craigyjp/Moog-Source-clone/schematics/VCO1.pdf

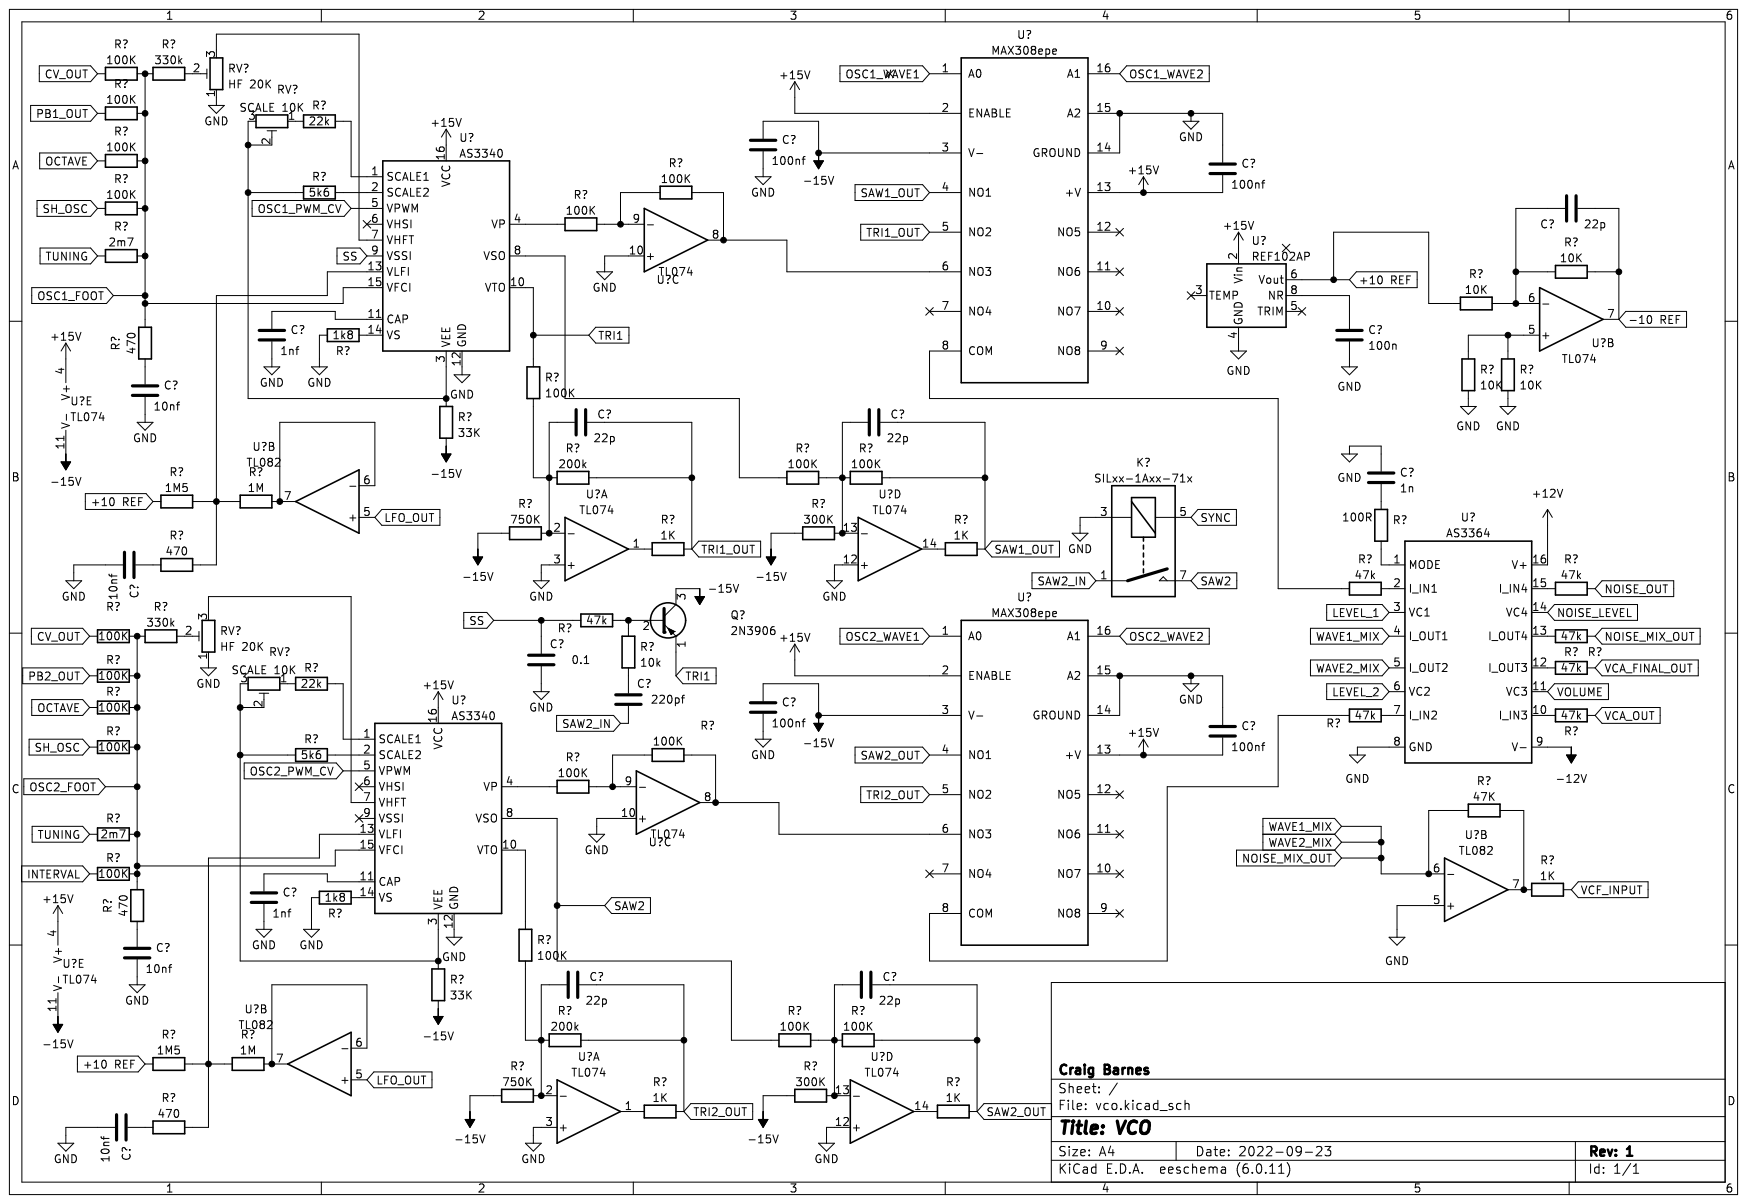
[picture p2: page 1]
