craigyjp/Moog-Source-clone/schematics/DACs2.pdf

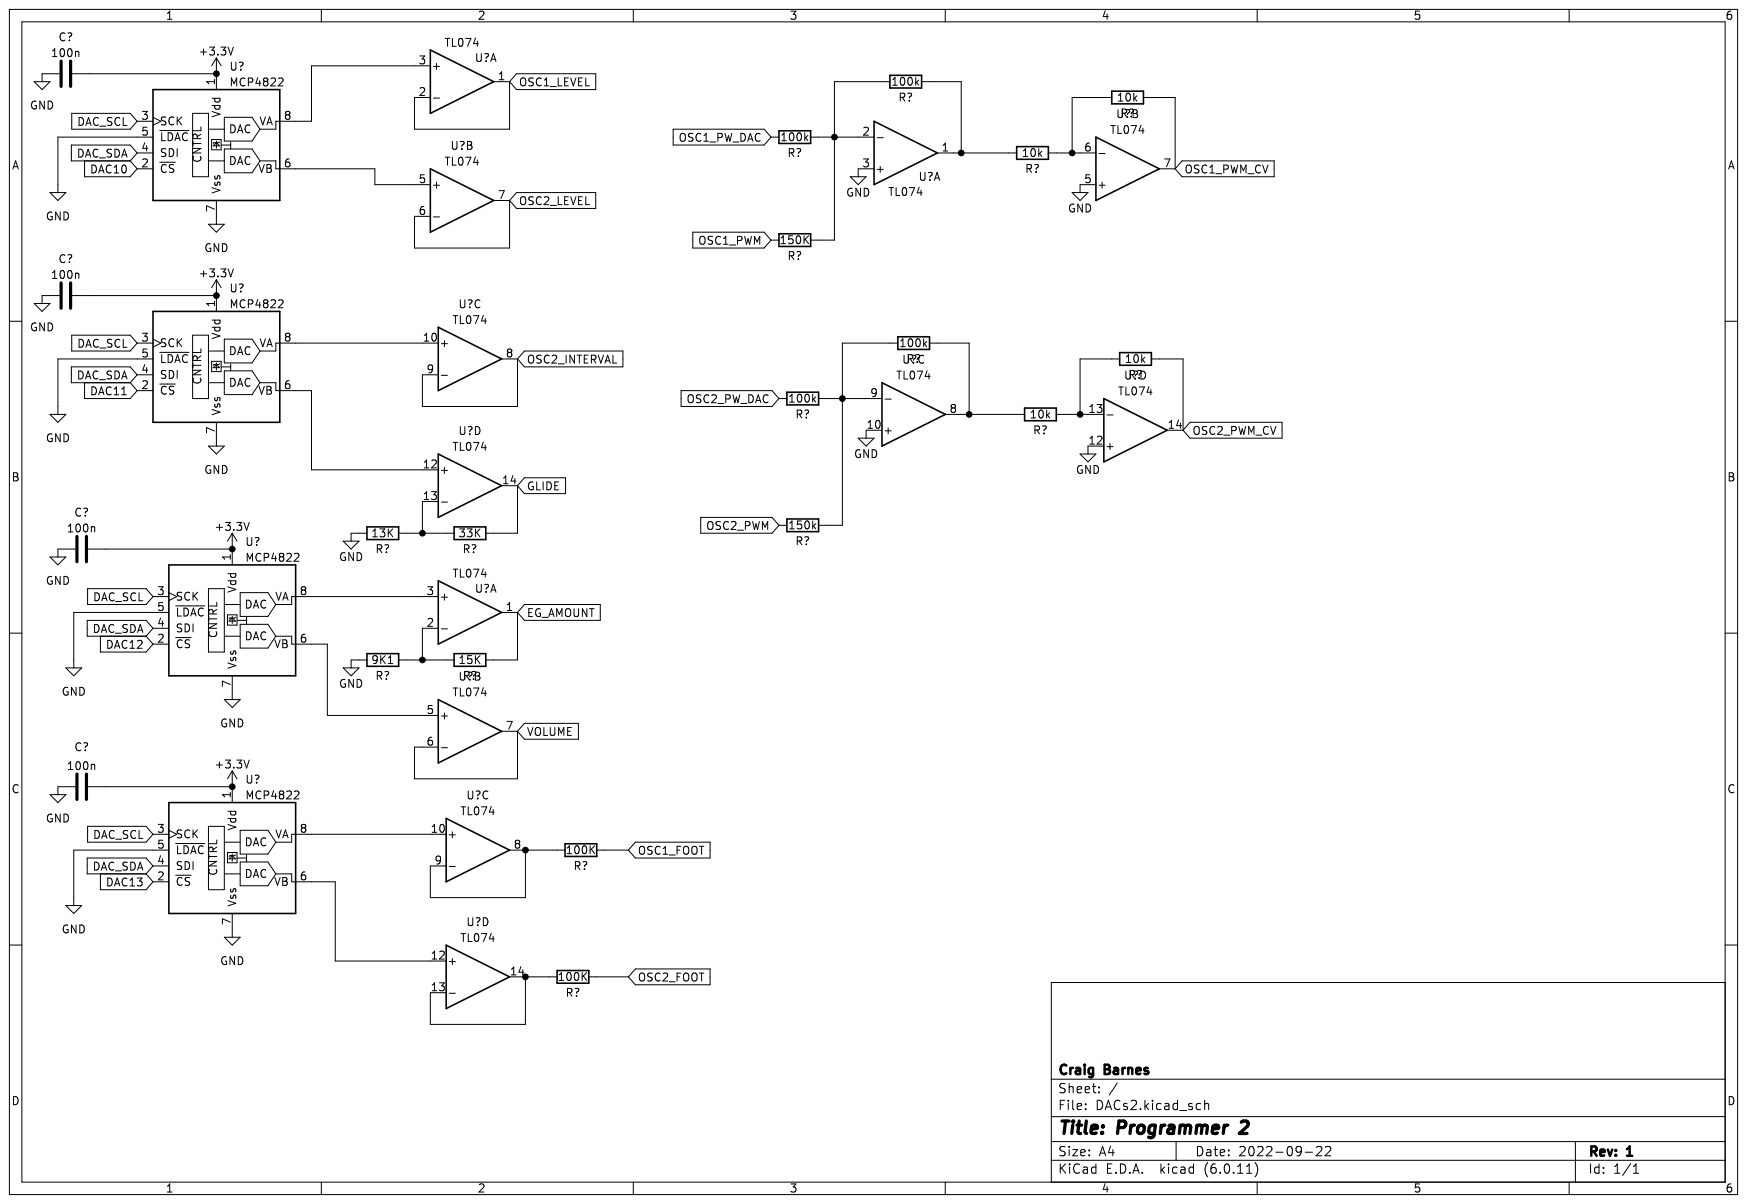
[picture p3: page 1]
