craigyjp/Moog-Source-clone/schematics/filter.pdf

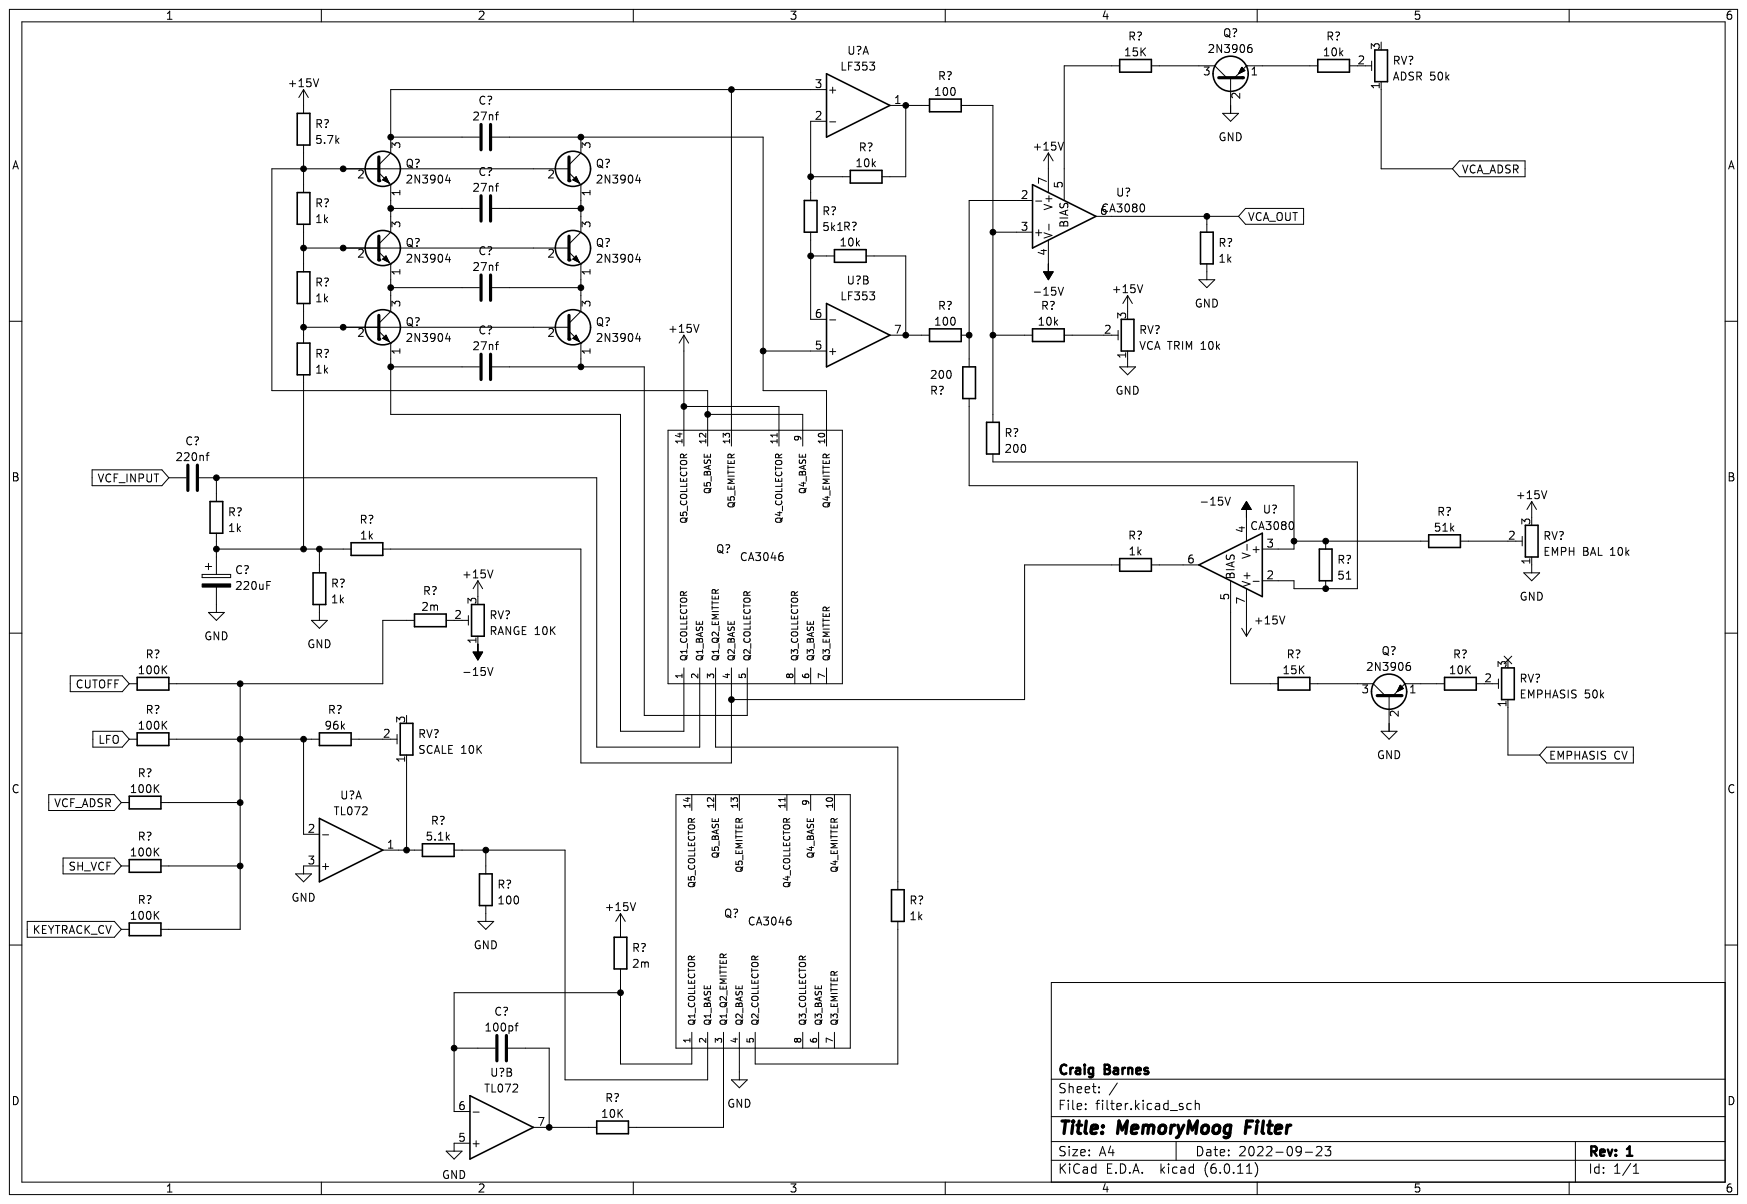
[picture p4: page 1]
