craigyjp/Moog-Source-clone/schematics/Routing_and_EGs.pdf

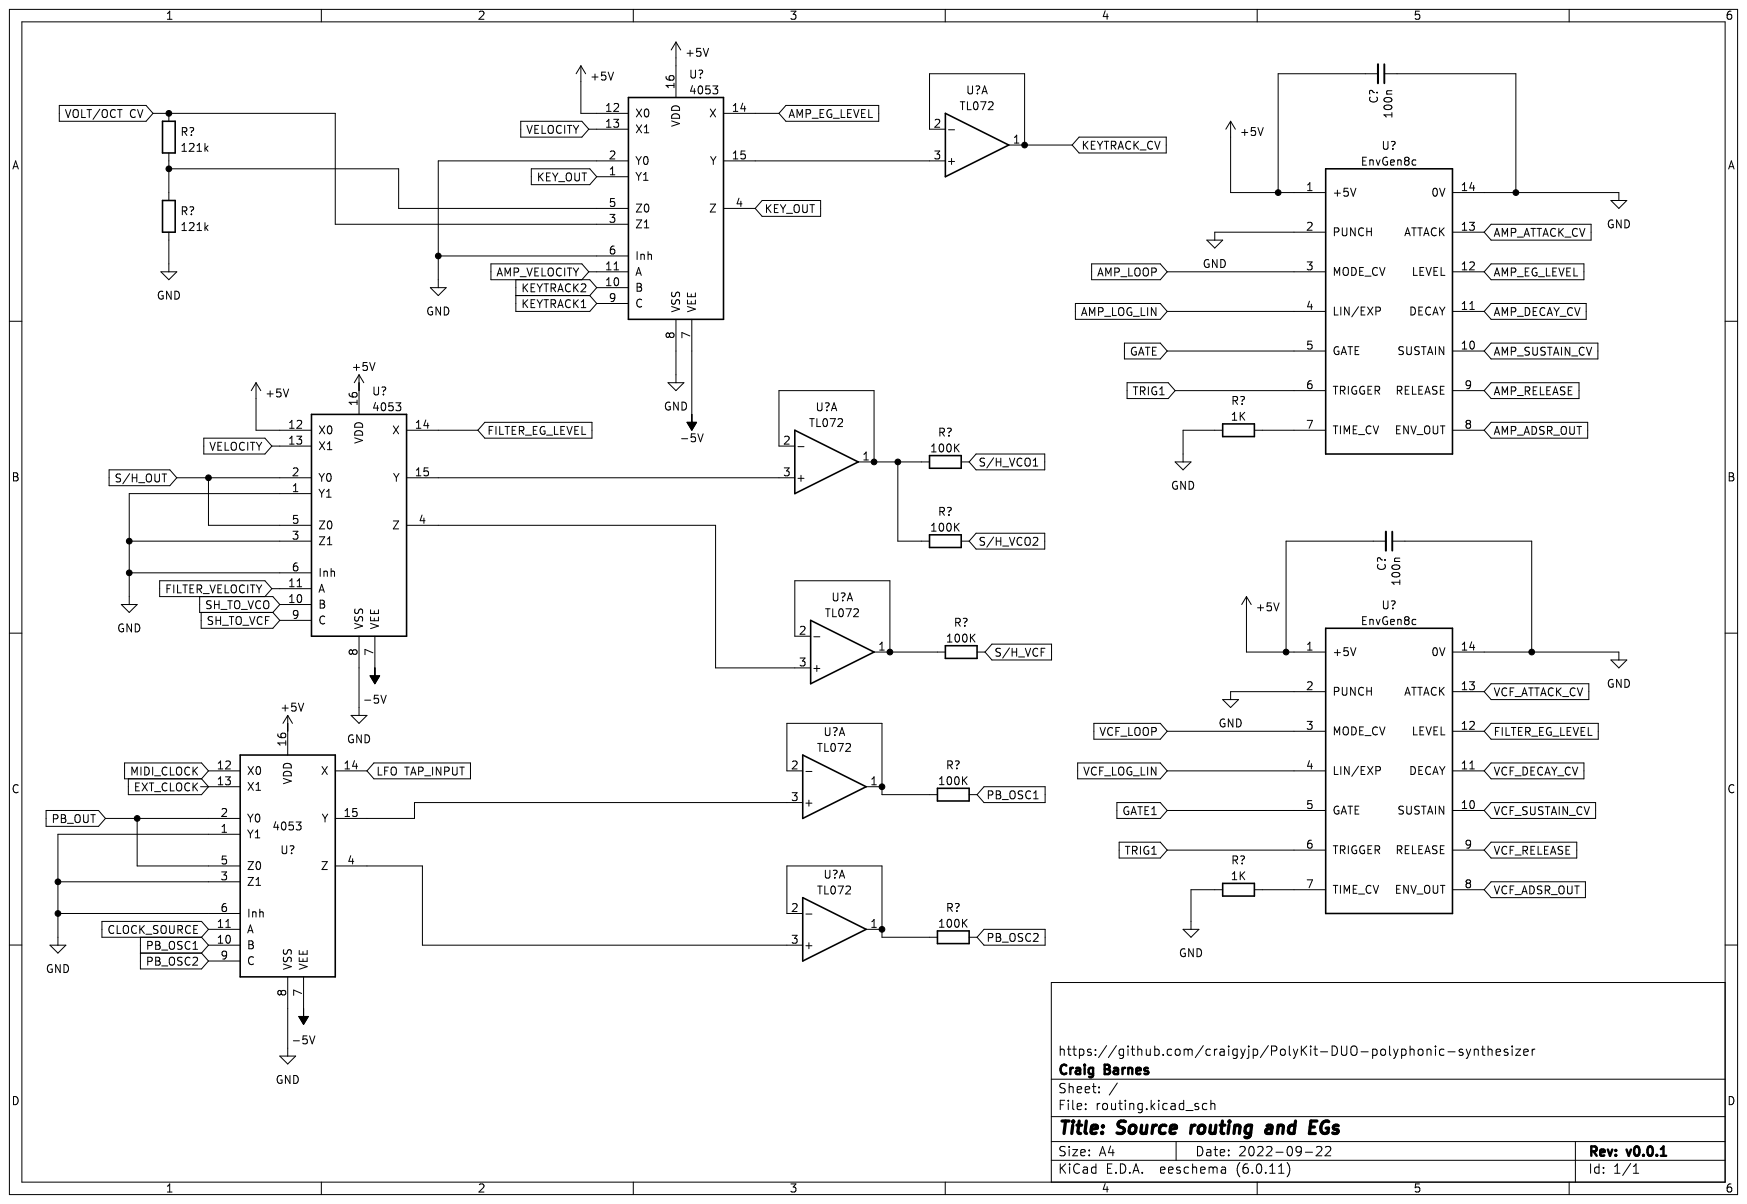
[picture p5: page 1]
