craigyjp/Moog-Source-clone/schematics/Teensy 3.6.pdf

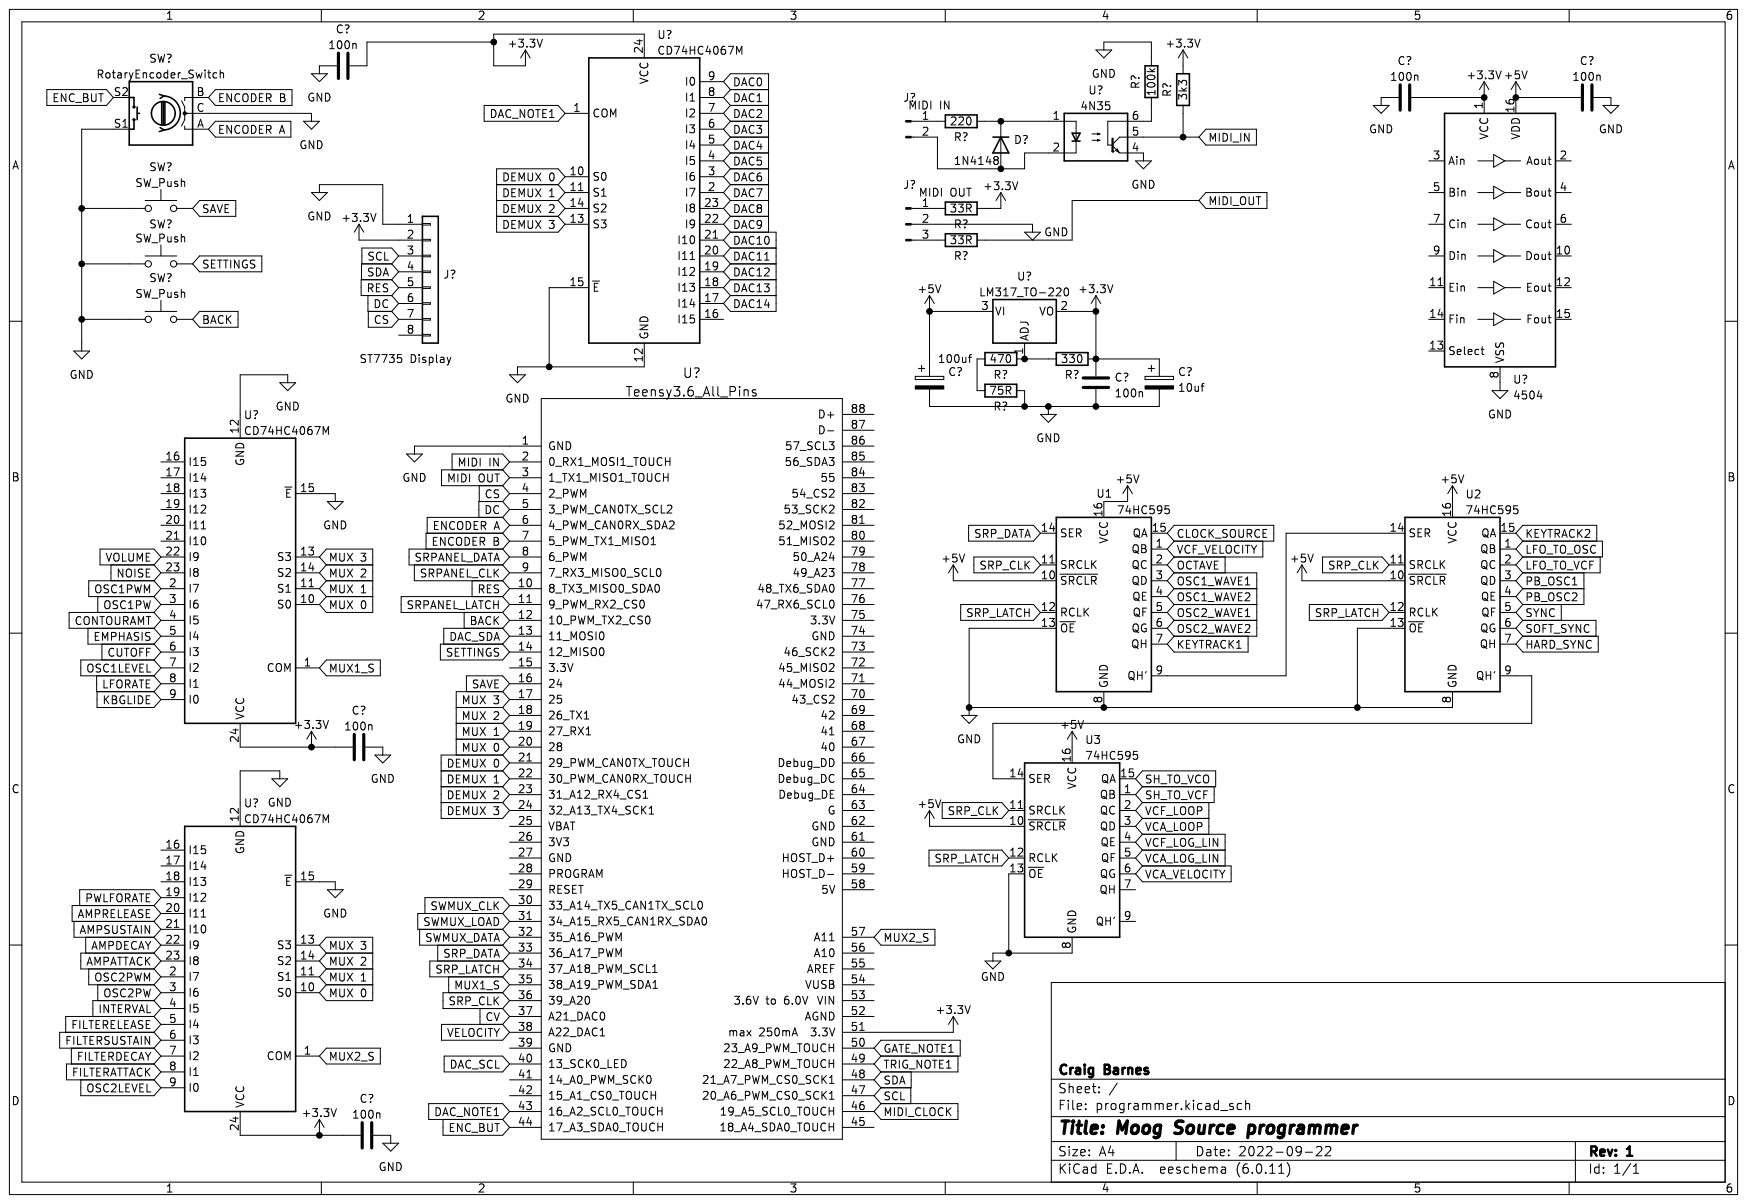
[picture p6: page 1]
