craigyjp/Moog-Source-clone/schematics/Frontpanel_switches_and_leds.pdf

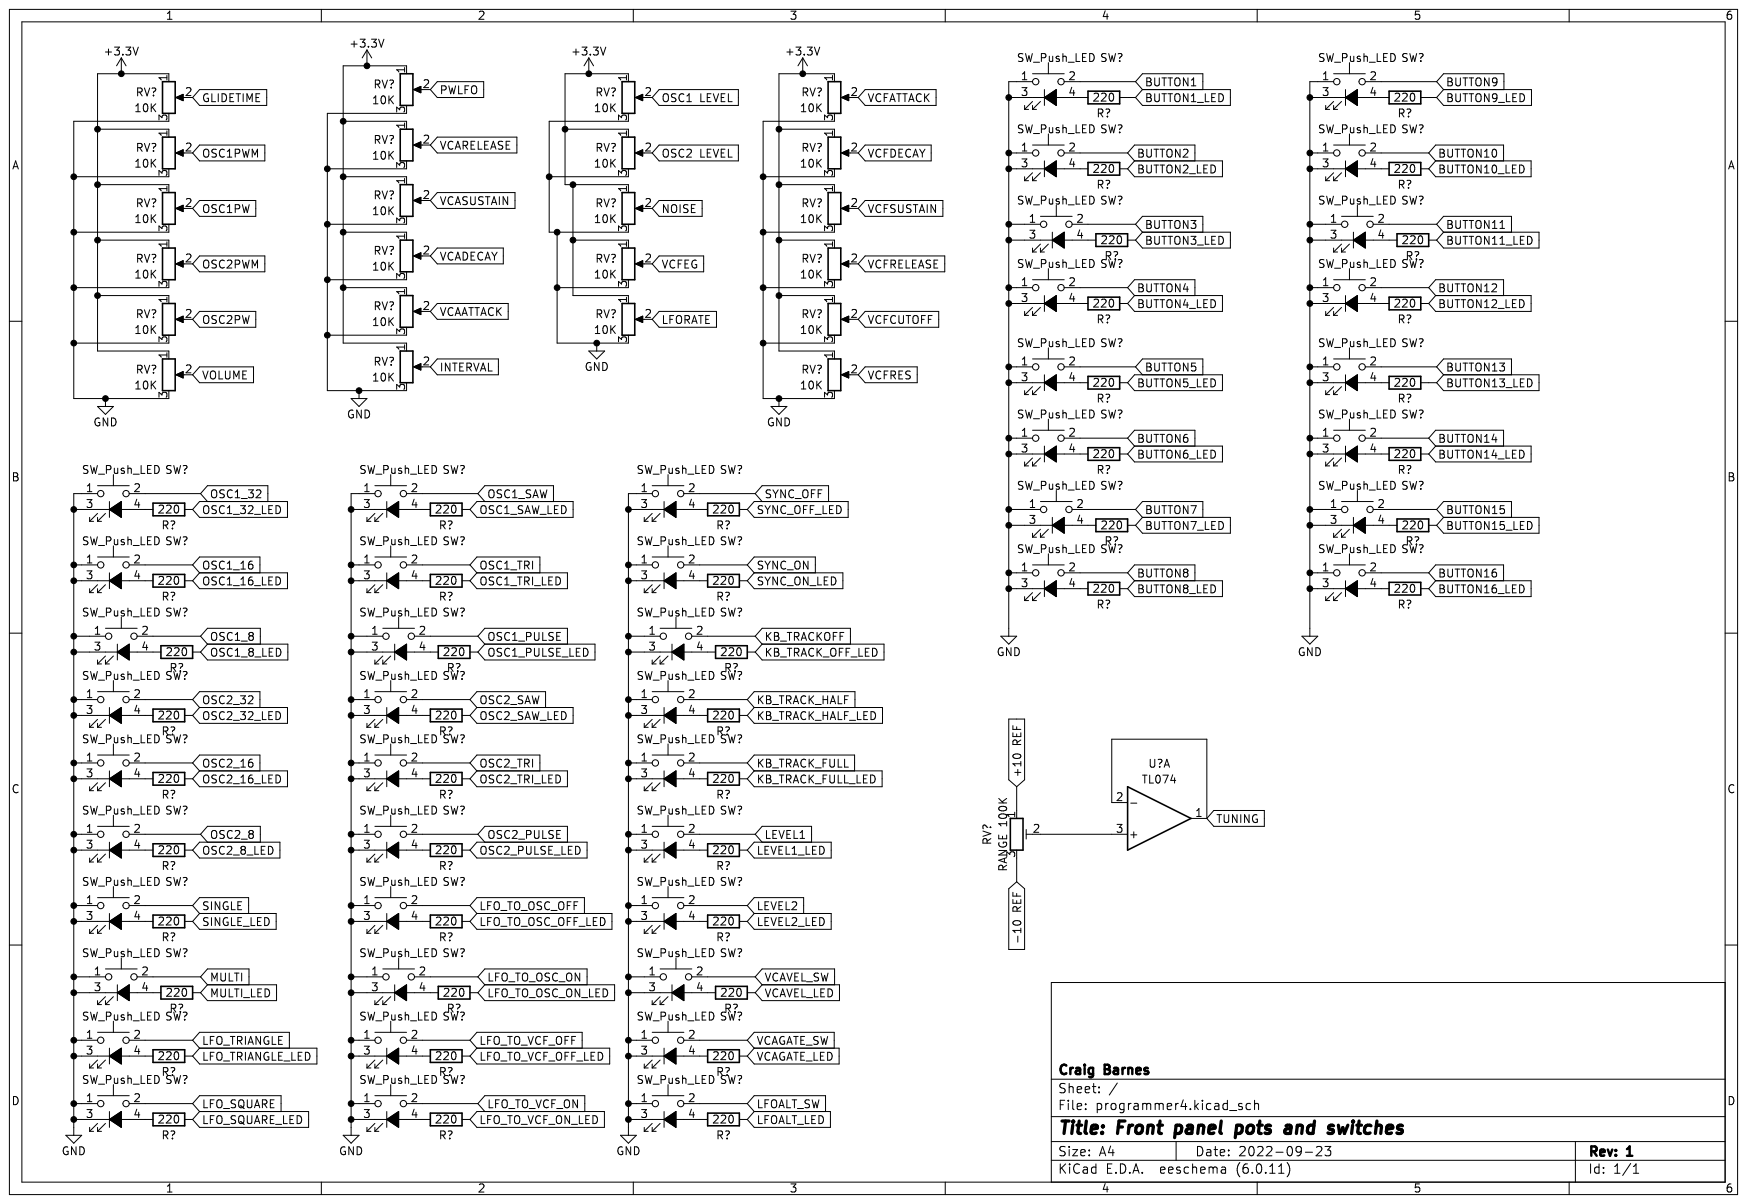
[picture p7: page 1]
