craigyjp/Moog-Source-clone/schematics/LFOs.pdf

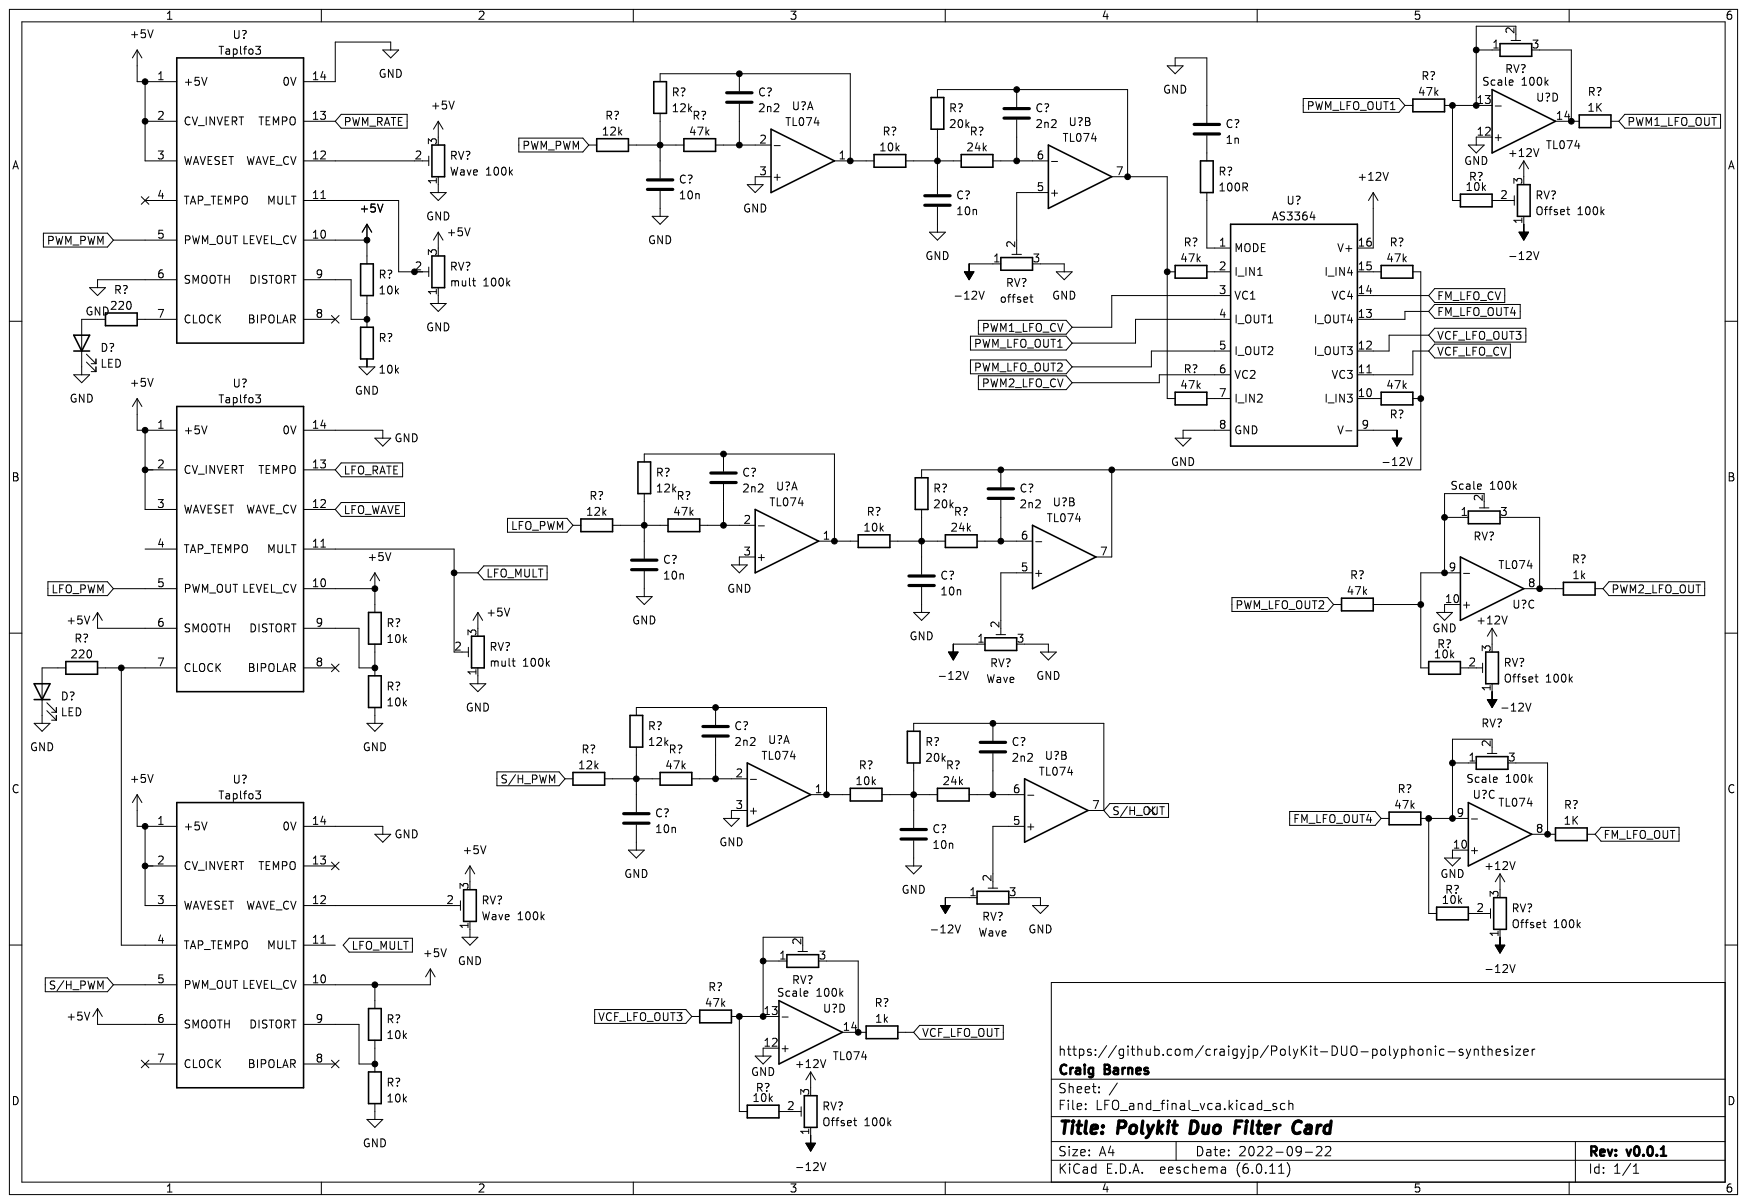
[picture p8: page 1]
