craigyjp/Moog-Source-clone/schematics/VCO2.pdf

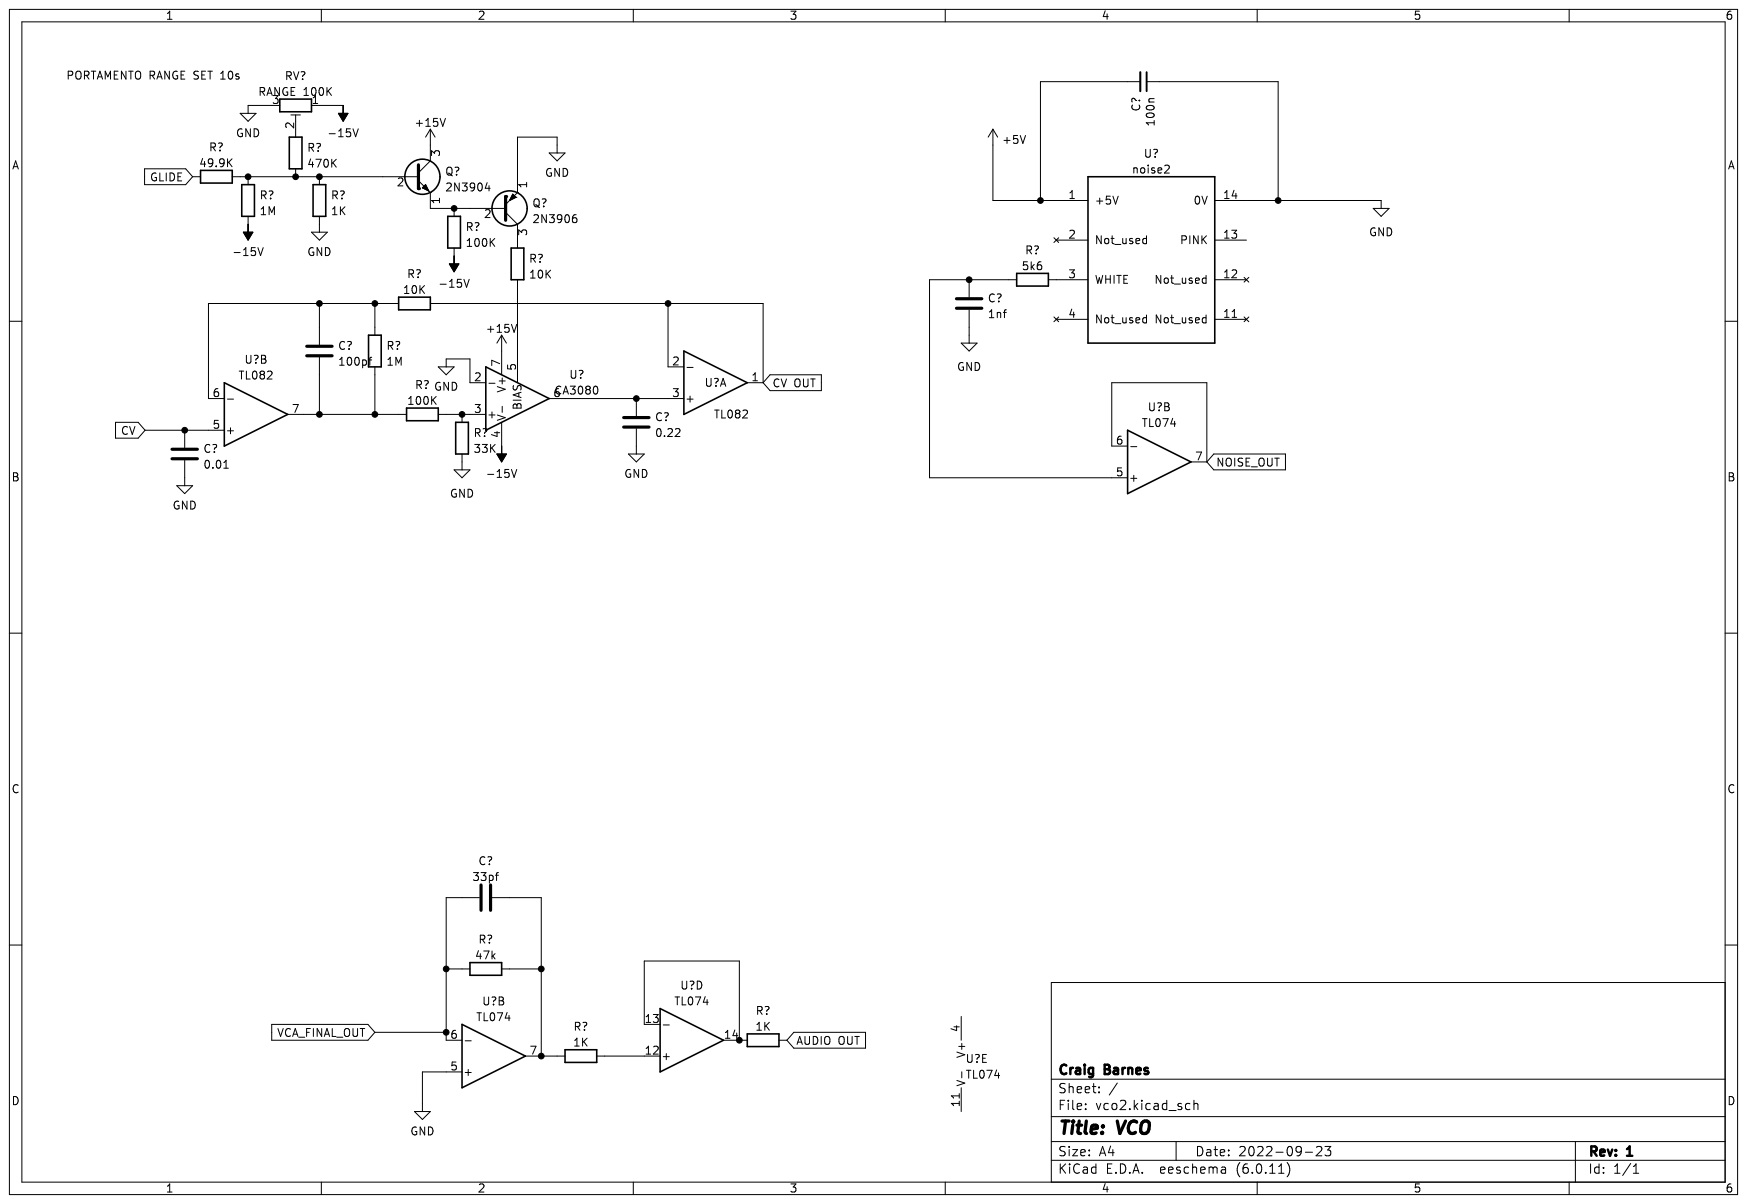
[picture p9: page 1]
