craigyjp/Moog-Source-clone/schematics/DACs1.pdf

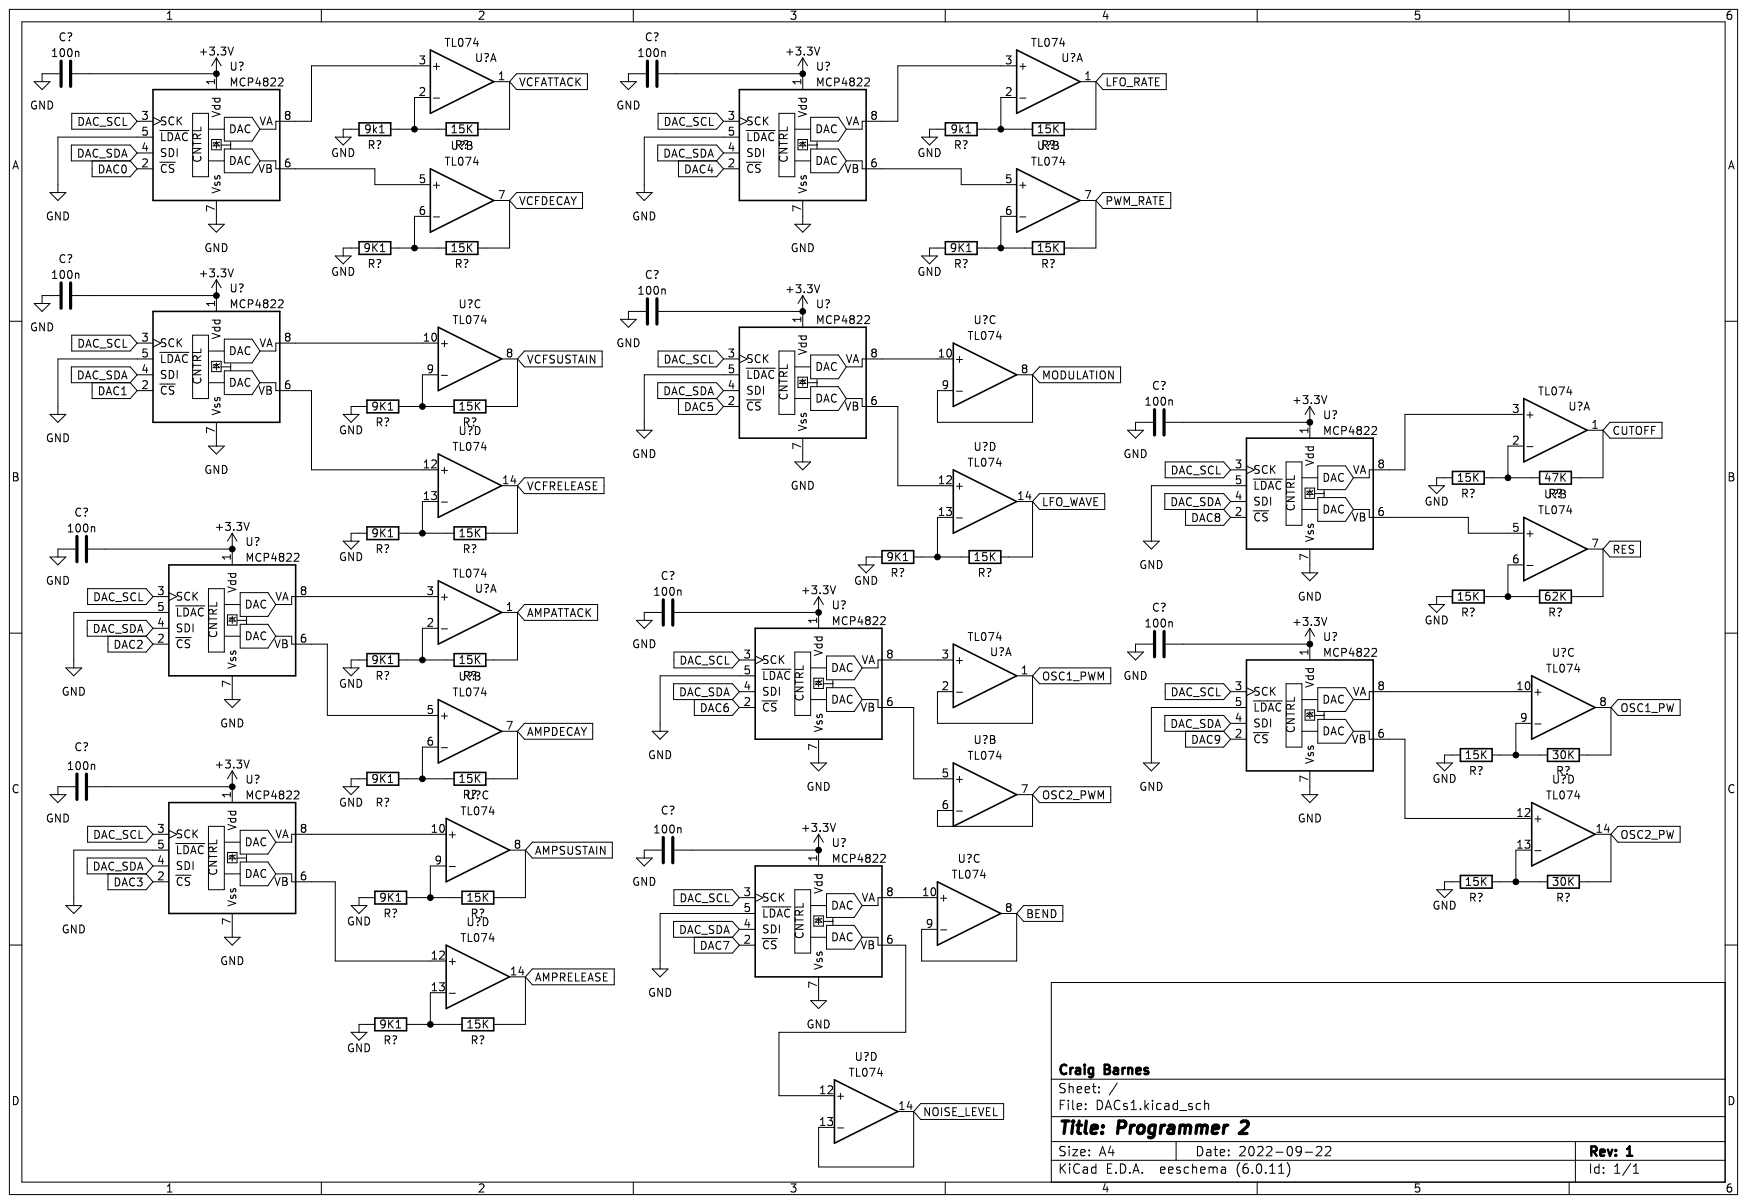
[picture p10: page 1]
