craigyjp/Moog-Source-clone/code/Parameters.h

//Values below are just for initialising and will be changed when synth is initialised to current panel controls & EEPROM settings
byte midiChannel = MIDI_CHANNEL_OMNI;//(EEPROM)
String patchName = INITPATCHNAME;
boolean encCW = true;//This is to set the encoder to increment when turned CW - Settings Option

unsigned int CV =0;
unsigned int velCV = 0;

constexpr int POT_MAX = 1023;
constexpr int DETUNE_END = POT_MAX / 4;

int offset;

int modWheelDepth = 0;
int pitchBendRange = 0;
int afterTouchDepth = 0;
int bended = 1024;
int keyMode = 0;
static unsigned long clock_timer = 0, clock_timeout = 0;
static unsigned int clock_count = 0;
int clocksource = 0;
int oldclocksource = 0;
int oldnote = 0;

constexpr uint8_t MAX_ARP_STEPS = 24;

uint8_t arpNotes[MAX_ARP_STEPS];
uint8_t arpLength = 0;
uint8_t arpIndex  = 0;

bool arpEnabled   = false;   // Button 9
bool arpPlaying   = false;
bool arpRecording = false;

uint8_t firstArpNote = 0;
bool firstNoteSet = false;

elapsedMicros arpTimer;

uint32_t arpStepMicros = 250000;   // derived from LFO
uint32_t arpGateMicros = 200000;   // ~80%

enum ArpPhase {
  ARP_GATE_OFF,
  ARP_GATE_ON
};

ArpPhase arpPhase = ARP_GATE_OFF;

constexpr uint8_t SEQ_MAX_STEPS = 64;
constexpr uint8_t SEQ_REST = 255;

struct StepSeq {
  uint8_t steps[SEQ_MAX_STEPS];
  uint8_t length = 0;      // number of recorded steps
  uint8_t index  = 0;      // playback position
};

StepSeq seq1, seq2;

bool seqEnabled = false;

enum SeqRunState { SEQ_IDLE, SEQ_RECORDING, SEQ_PLAYING, SEQ_STOPPED };
SeqRunState seqState = SEQ_IDLE;

uint8_t recordTarget = 0;     // 0 = none, 1 = seq1, 2 = seq2
uint8_t playTarget   = 0;     // 0 = none, 1 = seq1, 2 = seq2

elapsedMicros seqTimer;

uint32_t seqStepMicros = 250000;
uint32_t seqGateMicros = 200000;

enum SeqPhase { SEQ_GATE_OFF, SEQ_GATE_ON };
SeqPhase seqPhase = SEQ_GATE_OFF;

int noiseLevel = 0;
int noiseLevelstr = 0; // for display
int glide = 0;
int glidestr = 0; // for display

float volume = 0;
float volumestr = 0; // for display

int osc1_32 = 0;
int osc1_32switch = 0;
int osc1_16 = 0;
int osc1_16switch = 0;
int osc1_8 = 0;
int osc1_8switch = 0;

int osc1_saw = 0;
int osc1_sawswitch = 0;
int osc1_tri = 0;
int osc1_triswitch = 0;
int osc1_pulse = 0;
int osc1_pulseswitch = 0;

int osc2_32 = 0;
int osc2_32switch = 0;
int osc2_16 = 0;
int osc2_16switch = 0;
int osc2_8 = 0;
int osc2_8switch = 0;

int osc2_saw = 0;
int osc2_sawswitch = 0;
int osc2_tri = 0;
int osc2_triswitch = 0;
int osc2_pulse = 0;
int osc2_pulseswitch = 0;

int single;
int singleswitch = 0;
int multi;
int multiswitch = 0;
int gatepulse;

int lfoTriangle = 0;
int lfoTriangleswitch = 0;
int lfoSquare = 0;
int lfoSquareswitch = 0;
int lfoOscOff = 0;
int lfoOscOffswitch = 0;
int lfoOscOn = 0;
int lfoOscOnswitch = 0;
int lfoVCFOff = 0;
int lfoVCFOffswitch = 0;
int lfoVCFOn = 0;
int lfoVCFOnswitch = 0;

int syncOff = 0;
int syncOffswitch = 0;
int syncOn = 0;
int syncOnswitch = 0;

int level1 = 1;
int level1switch = 0;
int level2 = 0;
int level2switch = 0;


int octave0 = 0;
int octave0switch = 0;
int octave1 = 0;
int octave1switch = 0;

int kbOff = 0;
int kbOffswitch = 0;
int kbHalf = 0;
int kbHalfswitch = 0;
int kbFull = 0;
int kbFullswitch = 0;

int lfoVCO = 0;
int lfoVCF = 0;

int button1 = 0;
int button1switch = 0;
int button2 = 0;
int button2switch = 0;
int button3 = 0;
int button3switch = 0;
int vcfVelocity = 0;
int button4 = 0;
int button4switch = 0;
int vcaVelocity = 0;
int button5 = 0;
int button5switch = 0;
int vcfLoop= 0;
int button6 = 0;
int button6switch = 0;
int vcaLoop = 0;
int button7 = 0;
int button7switch = 0;
int vcfLinear = 0;
int button8 = 0;
int button8switch = 0;
int vcaLinear = 0;

int button9 = 0;
int button9switch = 0;
int button10 = 0;
int button10switch = 0;
int shvco = 0;
int button11 = 0;
int button11switch = 0;
int shvcf = 0;
int button12 = 0;
int button12switch = 0;
int button13 = 0;
int button13switch = 0;
int button14 = 0;
int button14switch = 0;
int button15 = 0;
int button15switch = 0;
int button16 = 0;
int button16switch = 0;

int returnvalue = 0;

int LfoRate = 0;
float LfoRatestr = 0; //for display
int LfoWave = 0;
int LfoWavestr = 0; //for display
int pwLFO = 0;
float pwLFOstr = 0; // for display

int osc2level = 0; // for display
int osc2levelstr = 0;
int osc1levelstr = 0; //for display
int osc1level = 0;

int osc1foot = 0;
int osc2foot = 0;

int osc1PW = 0;
int osc1PWstr = 0;
int osc2PW = 0;
int osc2PWstr = 0;
int osc2PWM = 0;
int osc2PWMstr = 0;
int osc1PWM = 0;
int osc1PWMstr = 0;

int ampAttack = 0;
int ampAttackstr = 0;
int ampDecay = 0;
int ampDecaystr = 0;
int ampSustain = 0;
int ampSustainstr = 0;
int ampRelease = 0;
int ampReleasestr = 0;

int osc2interval = 0;
int osc2intervalstr = 0;

int filterAttack = 0;
int filterAttackstr = 0;
int filterDecay = 0;
int filterDecaystr = 0;
int filterSustain = 0;
int filterSustainstr = 0;
int filterRelease = 0;
int filterReleasestr = 0;

int filterRes = 0;
int filterResstr = 0;
int filterCutoff = 12000;
float filterCutoffstr = 12000; // for display
int filterLevel = 0;
int filterLevelstr = 0;
