craigyjp/Moog-Source-clone/(commit log)

2023-04-24 updating schematics
2023-04-24 added kicad filter
2023-04-25 Fixed settings warnings and 74HC595 conflicts
    [Constants.h, HWControls.h, Parameters.h, ST7735Display.h, Settings.h, SettingsService.cpp, SettingsService.h, Source.ino]
2023-04-26 Updated switch library and routines
2023-04-26 V1.8 fixed LFO speed display
    [HWControls.h, Parameters.h, ST7735Display.h, Source.ino]
2023-04-27 fixed filter schematics
2023-04-28 Fixed to OSc and to VCF switching
    For some reason the toOsc and toVCF settings were not being set on patch recall. Fixed the method for setting these.
    [HWControls.h, MidiCC.h, Parameters.h, Source.ino]
2023-04-28 Fixed Single/Multi trigger code
    [Source.ino]
2023-04-29 Fixed the MIDI and external sync buttons
    [Source.ino]
2023-04-29 Fixed Top/Bottom note errors
    [Parameters.h, Source.ino]
2023-04-29 Fixed quick access level 2 switches
    [Source.ino]
2023-04-29 V1.9 fixed VCA velocity bug and Velocity levels
    [Constants.h, HWControls.h, Source.ino]
2023-04-29 Added PWM & PW Mixer
